adafruit/Adafruit-16-channel-PWM-Servo-Shield/Adafruit PWM Servo Shield.brd

## EAGLE design Adafruit PWM Servo Shield.brd (2013-12-18)

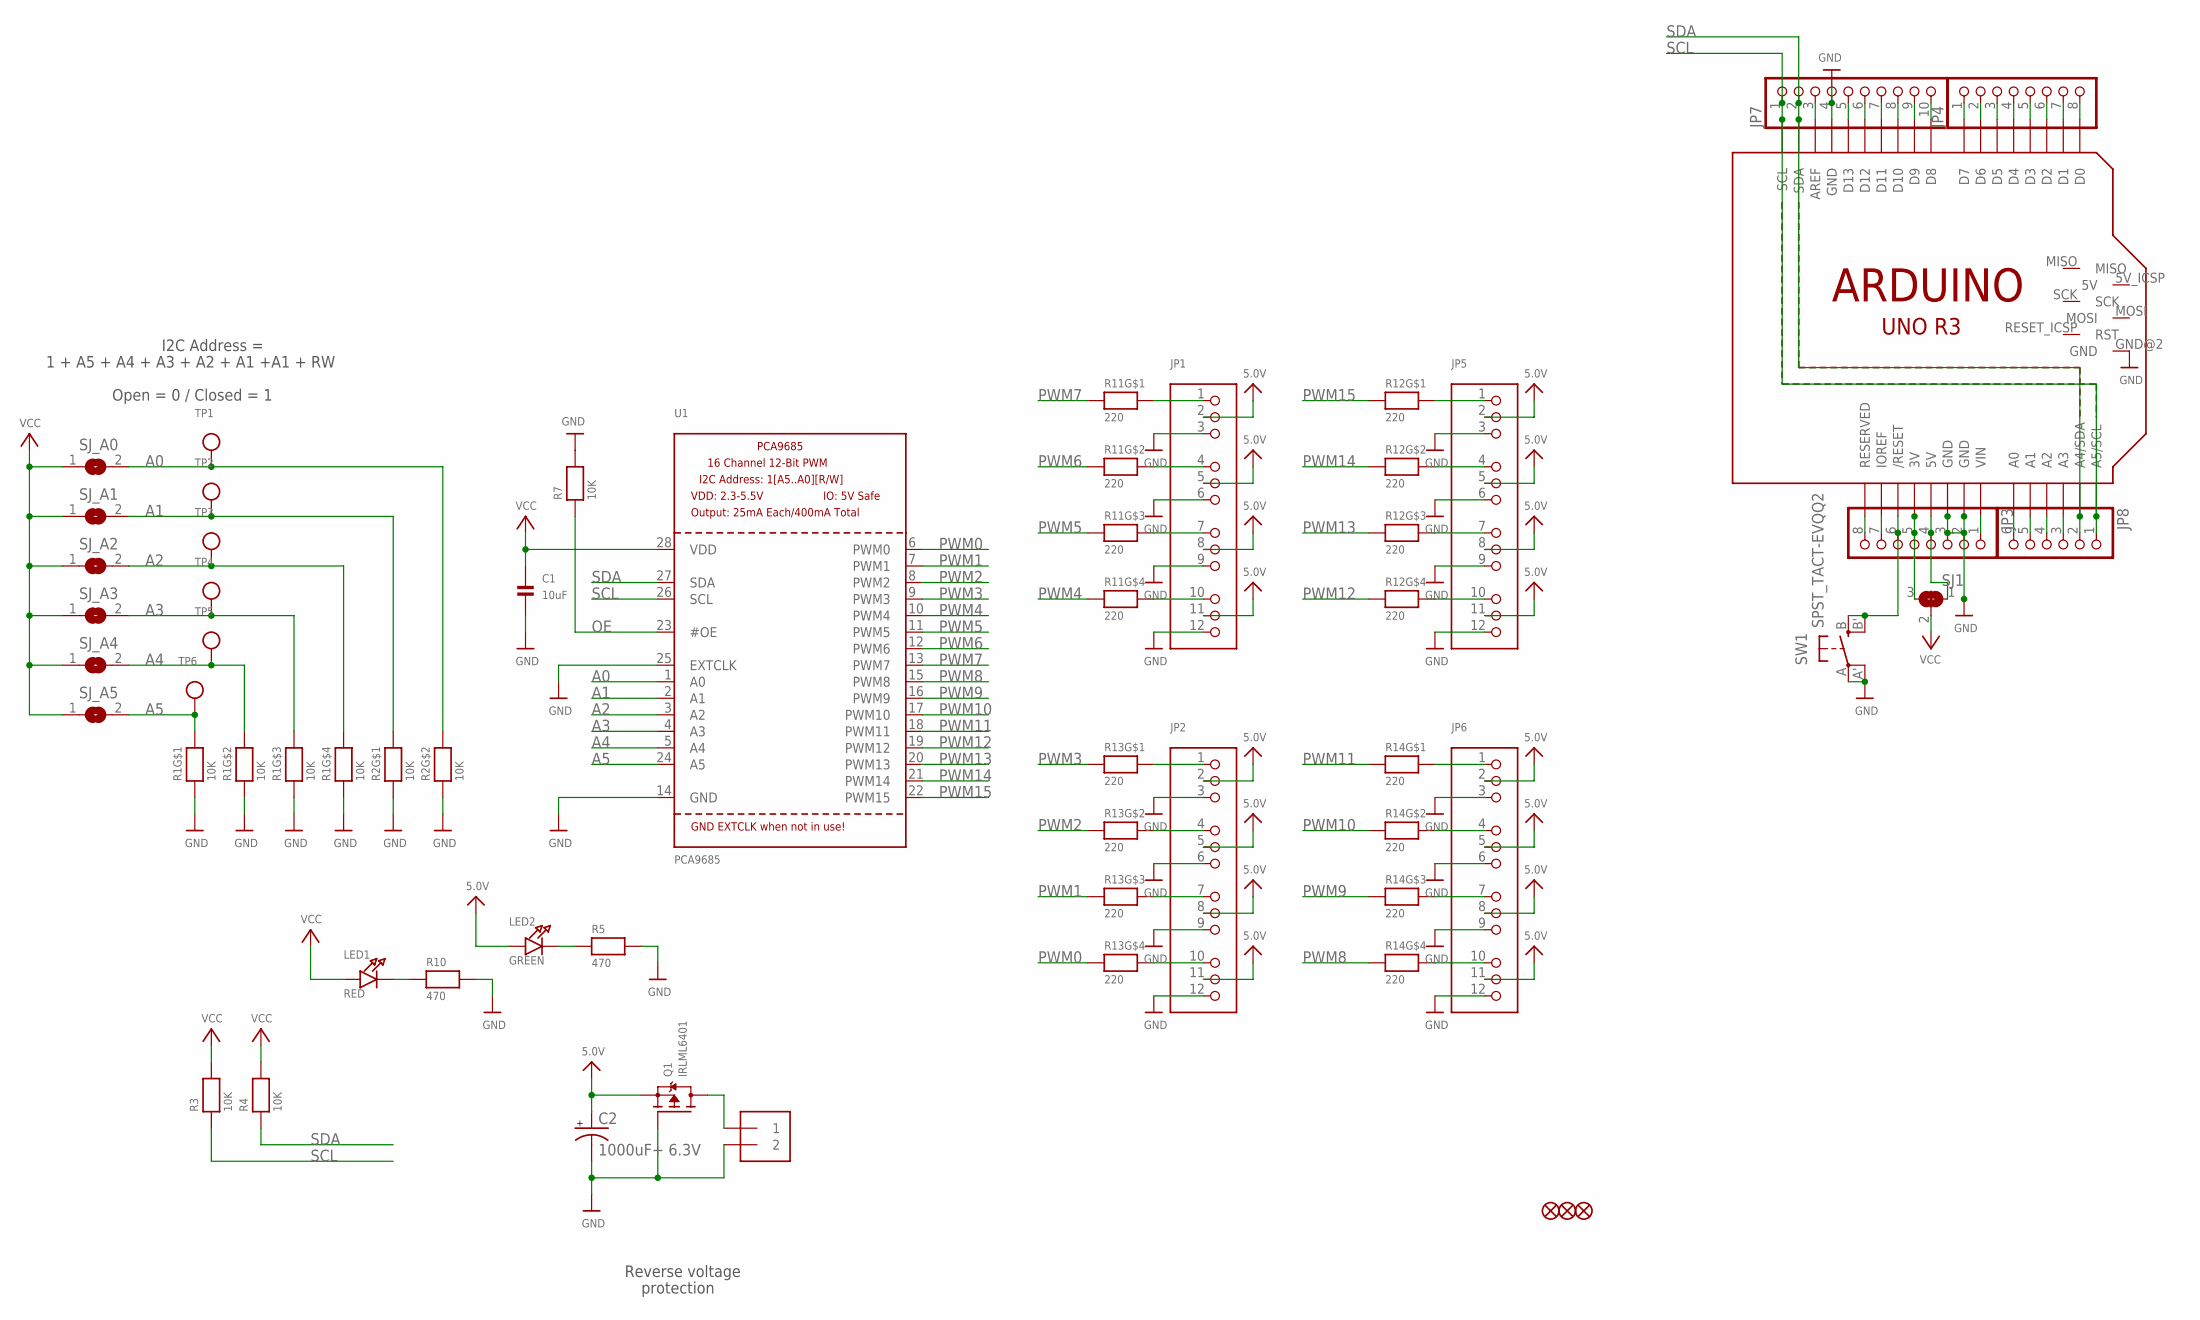
[picture p2: schematic Adafruit PWM Servo Shield.sch]

Parts:
C1: 10uF; 0805
C2: 1000uF+ 6.3V; E3,5-10
FID1, FID2, FID3: FIDUCIAL""; FIDUCIAL_1MM
J1: TERMBLOCK_1X2-3.5MM; 1X2-3.5MM
JP1, JP2, JP5, JP6: HEADER-3X04; 3X04
JP3, JP4: PINHD-1X8CLEANBIG; 1X08-CLEANBIG
JP7: HEADER-1X1070MIL; 1X10_ROUND70
JP8: PINHD-1X6CB; 1X06-CLEANBIG
LED1: RED; CHIPLED_0805
LED2: GREEN; CHIPLED_0805
Q1: IRLML6401; SOT23-WIDE
R1, R2: 10K; RESPACK_4X0603
R3, R4, R7: 10K; 0805
R5, R10: 470; 0805
R11, R12, R13, R14: 220; RESPACK_4X0603
SJ1: SOLDERJUMPER_2WAY; SOLDERJUMPER_2WAY_OPEN_NOPASTE
SJ_A0, SJ_A1, SJ_A2, SJ_A3, SJ_A4, SJ_A5: SOLDERJUMPERREFLOW_NOPASTE; SOLDERJUMPER_REFLOW_NOPASTE
SW1: SPST_TACT-EVQQ2; EVQ-Q2
TP1, TP2, TP3, TP4, TP5, TP6: TESTPOINTROUND2MM; TESTPOINT_ROUND_2MM
U1: PCA9685; TSSOP28
U$44: ARDUINO_R3_ICSP; ARDUINOR3_ICSP

Connections:
5.0V: C2.+, JP1.2, JP1.5, JP1.8, JP1.11, JP2.2, JP2.5, JP2.8, JP2.11, JP5.2, JP5.5, JP5.8, JP5.11, JP6.2, JP6.5, JP6.8, JP6.11, LED2.A, Q1.2 (S)
A0: R2.7 (2), SJ_A0.2, TP1.P$1, U1.1 (A0)
A1: R2.8 (2), SJ_A1.2, TP2.P$1, U1.2 (A1)
A2: R1.5 (2), SJ_A2.2, TP3.P$1, U1.3 (A2)
A3: R1.6 (2), SJ_A3.2, TP4.P$1, U1.4 (A3)
A4: R1.7 (2), SJ_A4.2, TP5.P$1, U1.5 (A4)
A5: R1.8 (2), SJ_A5.2, TP6.P$1, U1.24 (A5)
GND: C1.2, C2.-, J1.2, JP1.3, JP1.6, JP1.9, JP1.12, JP2.3, JP2.6, JP2.9, JP2.12, JP3.2, JP3.3, JP5.3, JP5.6, JP5.9, JP5.12, JP6.3, JP6.6, JP6.9, JP6.12, JP7.4, Q1.1 (G), R1.1, R1.2 (1), R1.3 (1), R1.4 (1), R2.1, R2.2 (1), R5.2, R7.2, R10.2, SW1.A, SW1.A' (P1), U1.14 (GND), U1.25 (EXTCLK), U$44.GND, U$44.GND@1 (GND), U$44.GND@2 (GND), U$44.GND@3 (GND)
unnamed: LED1.C, R10.1
unnamed: JP1.4, R11.7 (2)
unnamed: JP1.1, R11.8 (2)
unnamed: JP1.7, R11.6 (2)
unnamed: JP1.10, R11.5 (2)
unnamed: JP2.1, R13.8 (2)
unnamed: JP2.4, R13.7 (2)
unnamed: JP2.7, R13.6 (2)
unnamed: JP2.10, R13.5 (2)
unnamed: JP6.10, R14.5 (2)
unnamed: JP6.7, R14.6 (2)
unnamed: JP6.4, R14.7 (2)
unnamed: JP6.1, R14.8 (2)
unnamed: JP5.10, R12.5 (2)
unnamed: JP5.7, R12.6 (2)
unnamed: JP5.4, R12.7 (2)
unnamed: JP5.1, R12.8 (2)
unnamed: JP3.1, U$44.VIN
unnamed: LED2.C, R5.1
unnamed: JP3.5, SJ1.3, U$44.3V
unnamed: JP3.4, SJ1.1, U$44.5V
unnamed: JP3.7, U$44.IOREF
unnamed: JP3.8, U$44.RESERVED
unnamed: JP4.1, U$44.D7
unnamed: JP4.2, U$44.D6
unnamed: JP4.3, U$44.D5
unnamed: JP4.4, U$44.D4
unnamed: JP4.5, U$44.D3
unnamed: JP4.6, U$44.D2
unnamed: JP4.7, U$44.D1
unnamed: JP4.8, U$44.D0
unnamed: JP7.3, U$44.AREF
unnamed: JP7.5, U$44.D13
unnamed: JP7.6, U$44.D12
unnamed: JP7.7, U$44.D11
unnamed: JP7.8, U$44.D10
unnamed: JP7.9, U$44.D9
unnamed: JP7.10, U$44.D8
unnamed: JP8.3, U$44.A3
unnamed: JP8.4, U$44.A2
unnamed: JP8.5, U$44.A1
unnamed: JP8.6, U$44.A0
unnamed: JP3.6, SW1.B (S), SW1.B' (S1), U$44.RESET (/RESET)
OE: R7.1, U1.23 (#OE)
PWM0: R13.4 (1), U1.6 (PWM0)
PWM1: R13.3 (1), U1.7 (PWM1)
PWM2: R13.2 (1), U1.8 (PWM2)
PWM3: R13.1, U1.9 (PWM3)
PWM4: R11.4 (1), U1.10 (PWM4)
PWM5: R11.3 (1), U1.11 (PWM5)
PWM6: R11.2 (1), U1.12 (PWM6)
PWM7: R11.1, U1.13 (PWM7)
PWM8: R14.4 (1), U1.15 (PWM8)
PWM9: R14.3 (1), U1.16 (PWM9)
PWM10: R14.2 (1), U1.17 (PWM10)
PWM11: R14.1, U1.18 (PWM11)
PWM12: R12.4 (1), U1.19 (PWM12)
PWM13: R12.3 (1), U1.20 (PWM13)
PWM14: R12.2 (1), U1.21 (PWM14)
PWM15: R12.1, U1.22 (PWM15)
PWRIN: J1.1, Q1.3 (D)
SCL: JP7.1, JP8.1, R3.1, U1.26 (SCL), U$44.A5 (A5/SCL), U$44.SCL
SDA: JP7.2, JP8.2, R4.1, U1.27 (SDA), U$44.A4 (A4/SDA), U$44.SDA
VCC: C1.1, LED1.A, R3.2, R4.2, SJ1.2, SJ_A0.1, SJ_A1.1, SJ_A2.1, SJ_A3.1, SJ_A4.1, SJ_A5.1, U1.28 (VDD)

Notes on the sheet:
Reverse voltage
protection
1 + A5 + A4 + A3 + A2 + A1 +A1 + RW
I2C Address =
Open = 0 / Closed = 1

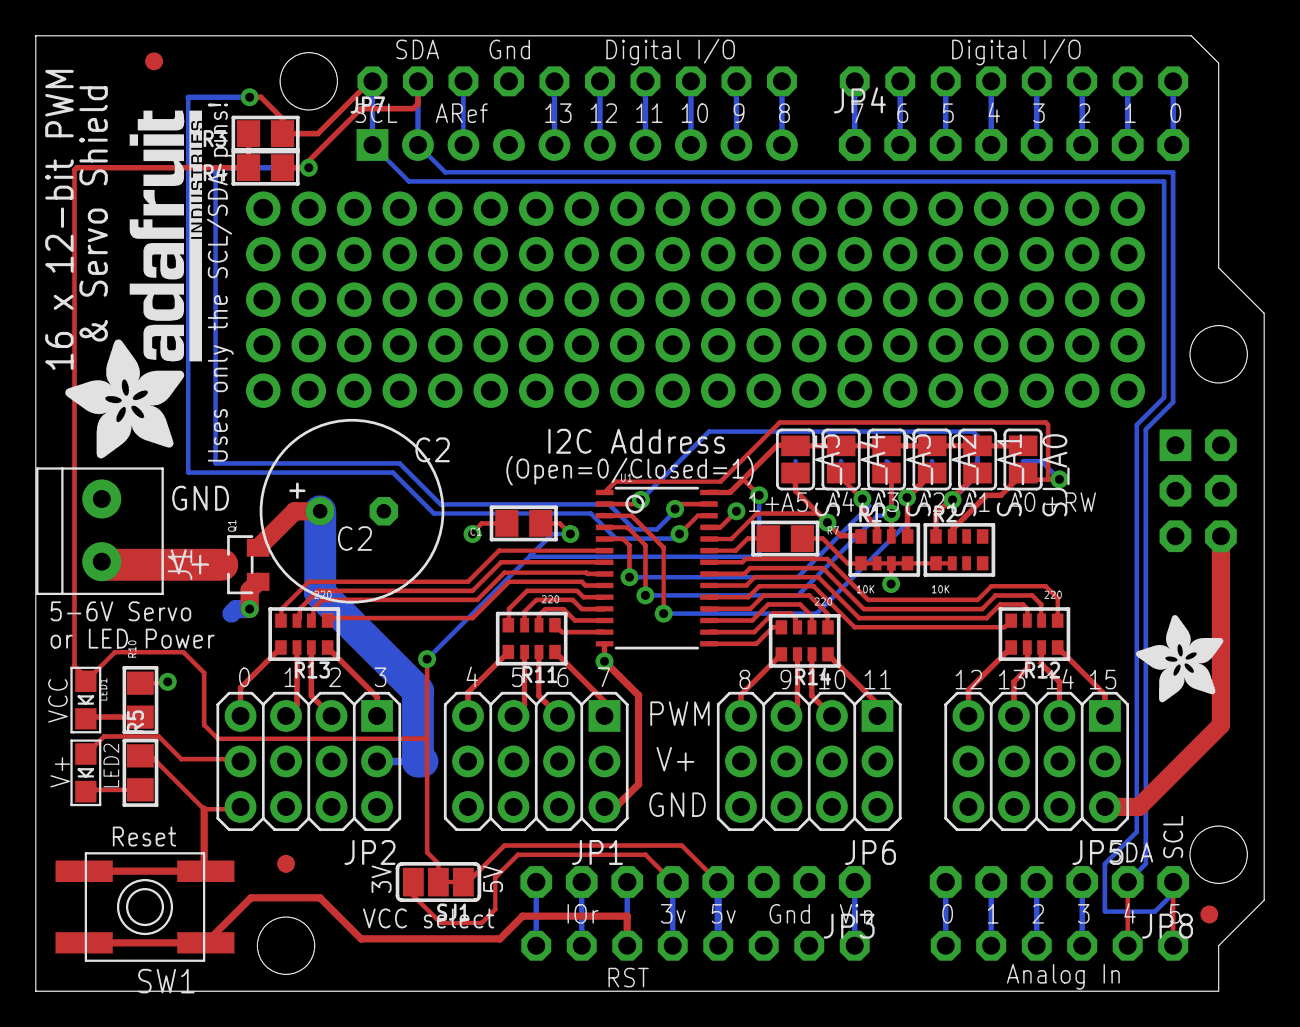
[picture p3: board Adafruit PWM Servo Shield.brd from above]

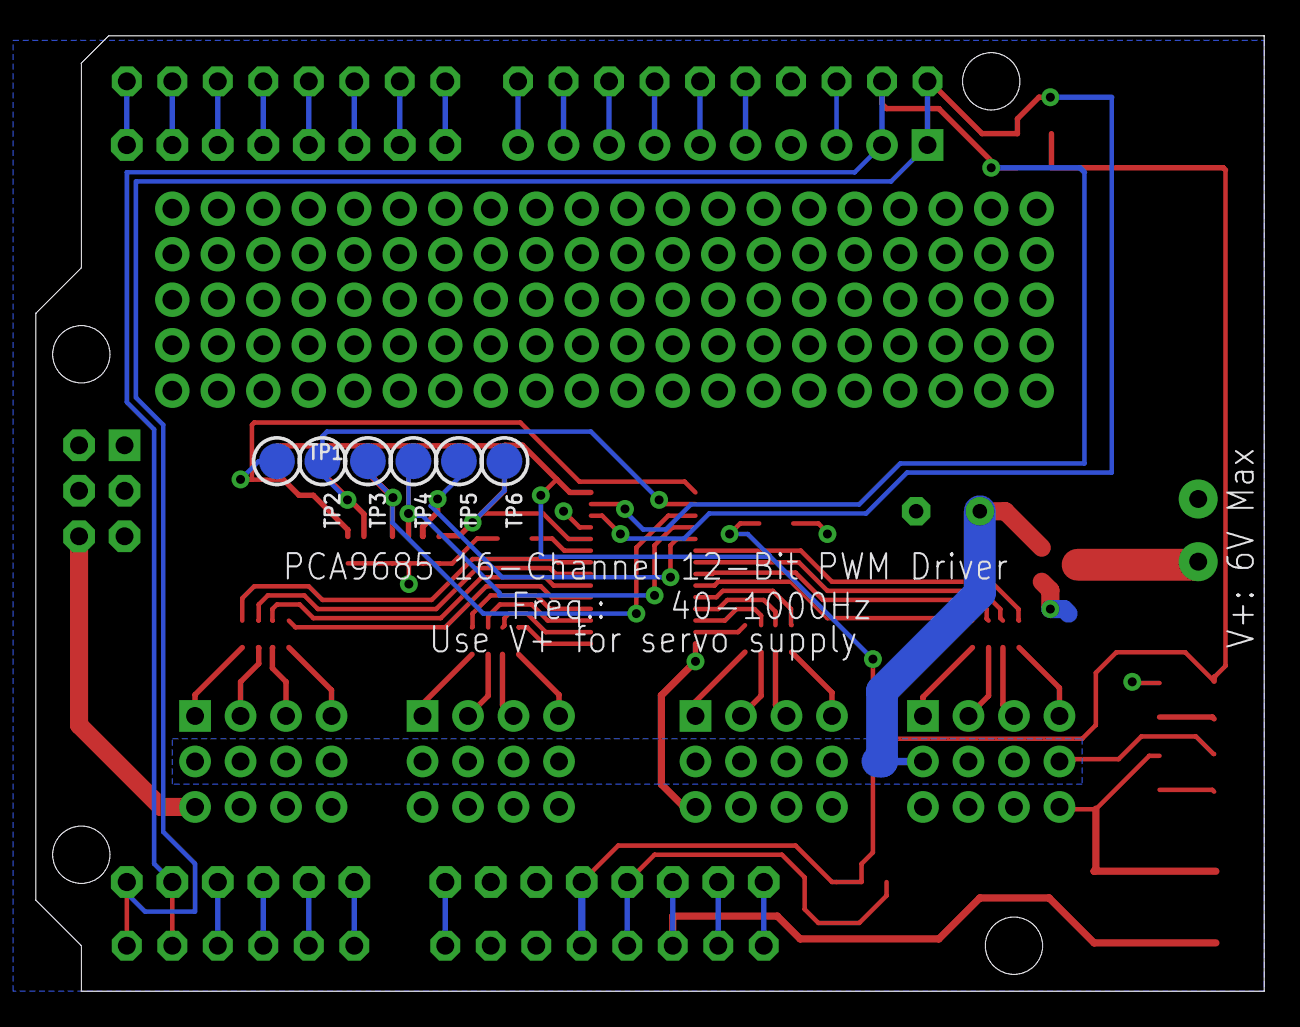
[picture p4: board Adafruit PWM Servo Shield.brd from below]

Board: 2 copper layers, 68.6 x 53.3 mm, 46 parts (6 on the bottom side), 72 nets.

Other parts of the board:
U$51: ADAFRUIT_5MM
U$54: ADAFRUIT_TEXT_20MM
